mschlenstedt/WeatherLox/README.md

# WeatherLox
DIY Weatherstation for Smarthomes and amateur meteorologist and enthusiasts.

https://www.weatherlox.de/
