mschlenstedt/WeatherLox/PCB/weatherlox-air/README.md

# WeatherLox
DIY Weatherstation for Smarthomes and amateur meteorologist and enthusiasts.

This PCB is for the temperature, humidity and air pressur sensor.





The breadboard looks like this:

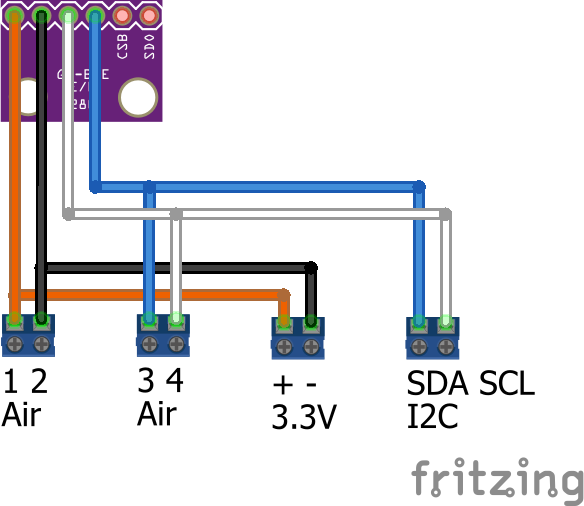
[picture p1: PCB/weatherlox-air/pictures/weatherlox-air-pcb_Steckplatine.png]
Breadboard for ESP32 Bottom
