mschlenstedt/WeatherLox/PCB/weatherlox-esp/README.md

# WeatherLox
DIY Weatherstation for Smarthomes and amateur meteorologist and enthusiasts.

This PCB is for the ESP32 and the additional Analog-Digital converter ADS1115 and the DC-DC step down.





The breadboard looks like this:

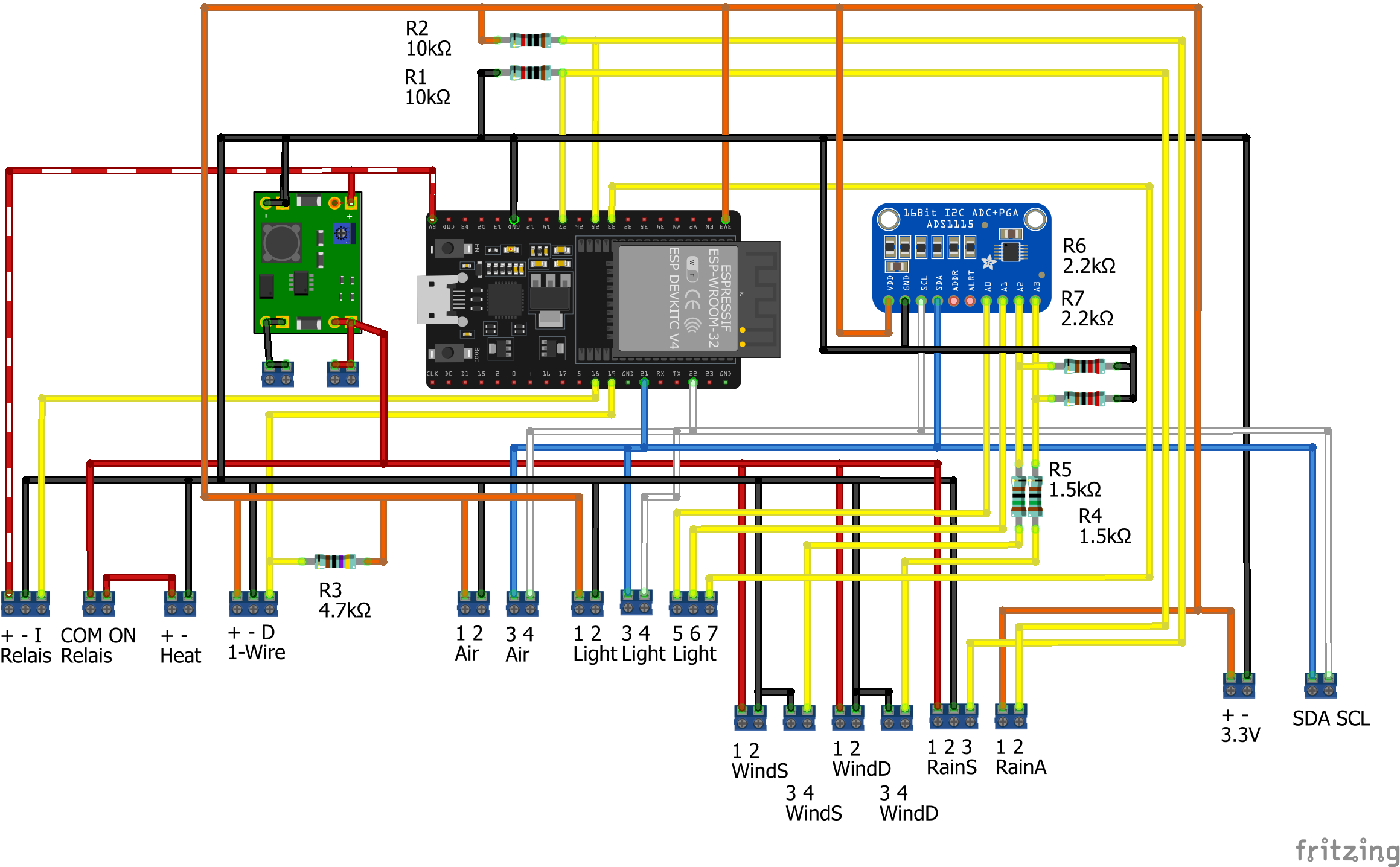
[picture p2: PCB/weatherlox-esp/pictures/weatherlox-esp-pcb_Steckplatine.png]
Breadboard for ESP32 Bottom
