mschlenstedt/WeatherLox/PCB/weatherlox-solar/README.md

# WeatherLox
DIY Weatherstation for Smarthomes and amateur meteorologist and enthusiasts.

This PCB is for the solar and light sensors as well as for the franklin sensor.





The breadboard looks like this:

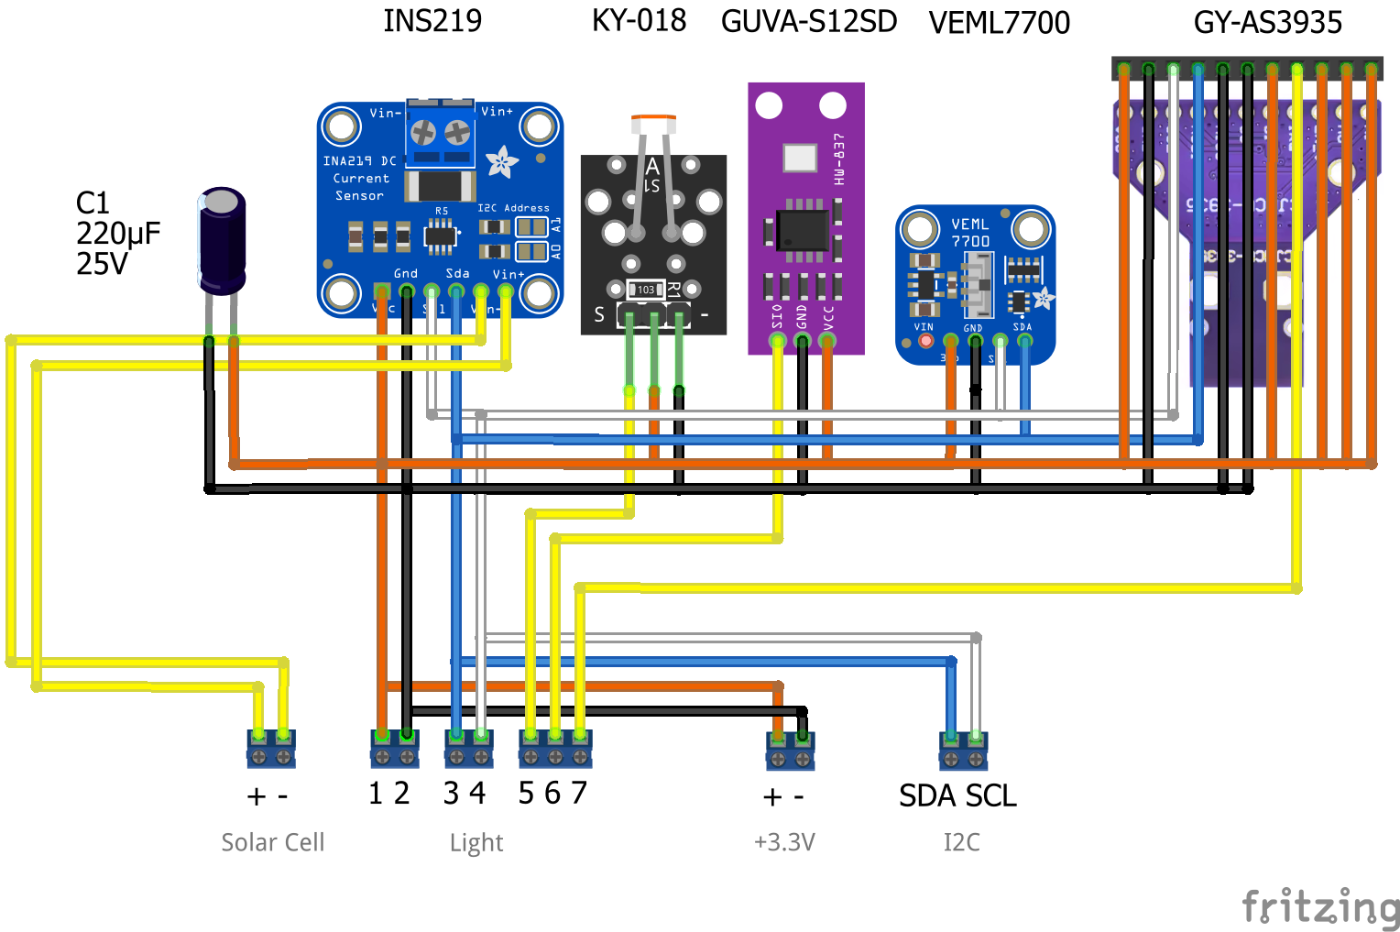
[picture p3: PCB/weatherlox-solar/pictures/weatherlox-solar-pcb_Steckplatine.png]
Breadboard for ESP32 Bottom
