mschlenstedt/WeatherLox/case/weatherlox-air/WeatherLox-Air-Adapter.step

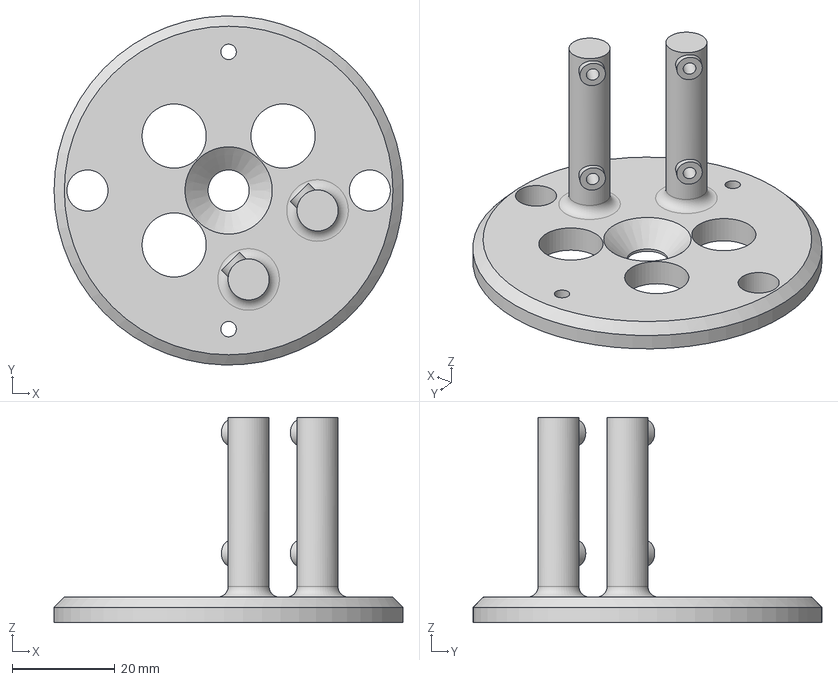
[picture p4: CAD file, 2026-03-01]
case/weatherlox-air/WeatherLox-Air-Adapter.step
67.9 x 68.0 x 40.0 mm
