mschlenstedt/WeatherLox/case/weatherlox-esp/Oberteil.stl

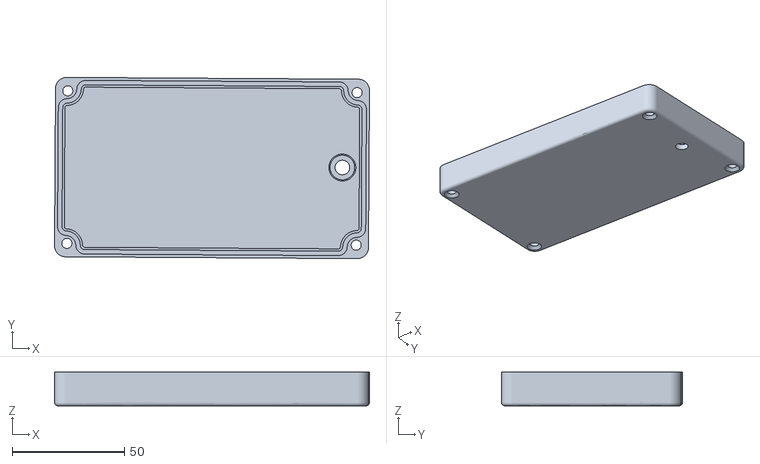
[picture p5: CAD file, 2026-01-30]
case/weatherlox-esp/Oberteil.stl
140.4 x 80.8 x 15.0
