mschlenstedt/WeatherLox/case/weatherlox-rain/WeatherLox-Rain-Adapter.step

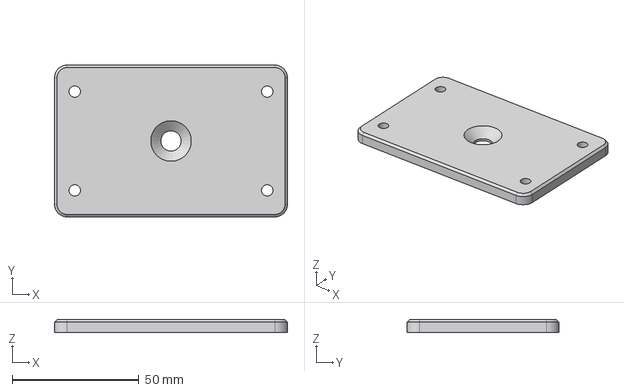
[picture p6: CAD file, 2026-03-01]
case/weatherlox-rain/WeatherLox-Rain-Adapter.step
92.0 x 60.0 x 5.00 mm
