mschlenstedt/WeatherLox/case/weatherlox-solar/Innenteil-2.stl

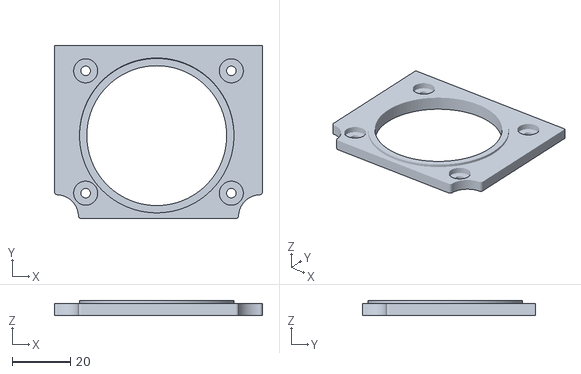
[picture p7: CAD file, 2026-01-30]
case/weatherlox-solar/Innenteil-2.stl
71.4 x 59.5 x 5.00
