mschlenstedt/WeatherLox/case/weatherlox-wind/WeatherLox-Wind-Adapter.step

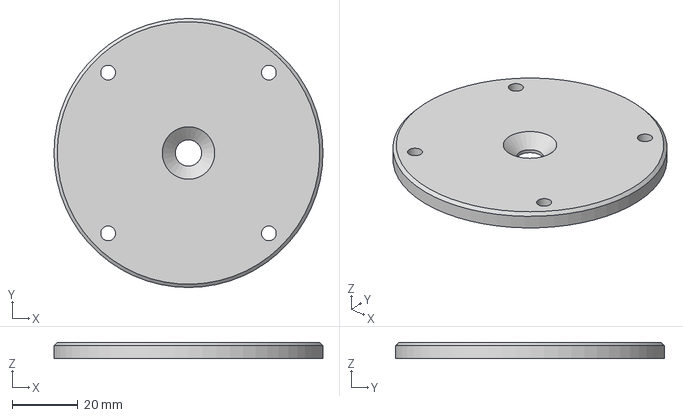
[picture p8: CAD file, 2026-01-02]
case/weatherlox-wind/WeatherLox-Wind-Adapter.step
82.0 x 82.0 x 5.00 mm
