mschlenstedt/WeatherLox/case/weatherlox-esp/Unterteil.stl

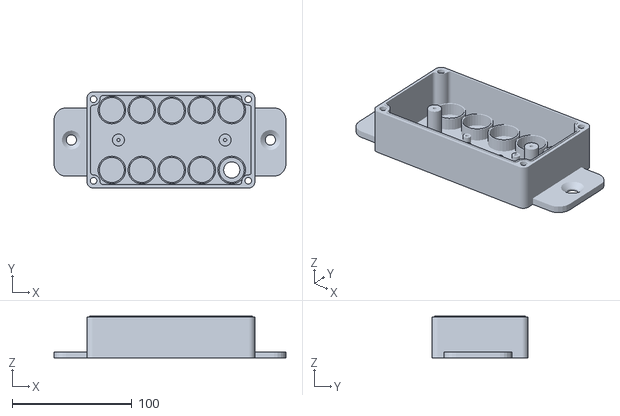
[picture p9: CAD file, 2026-01-30]
case/weatherlox-esp/Unterteil.stl
193.5 x 80.0 x 35.0
