mschlenstedt/WeatherLox/case/weatherlox-solar/Unterteil.stl

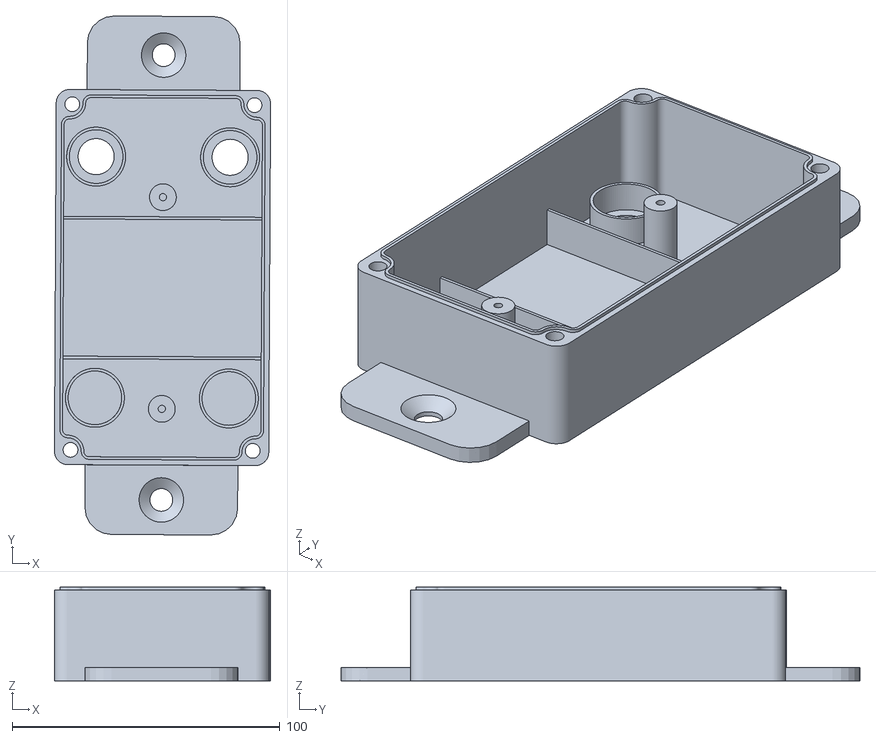
[picture p10: CAD file, 2026-01-30]
case/weatherlox-solar/Unterteil.stl
80.7 x 193.7 x 35.0
