mschlenstedt/WeatherLox/case/weatherlox-solar/Oberteil.stl

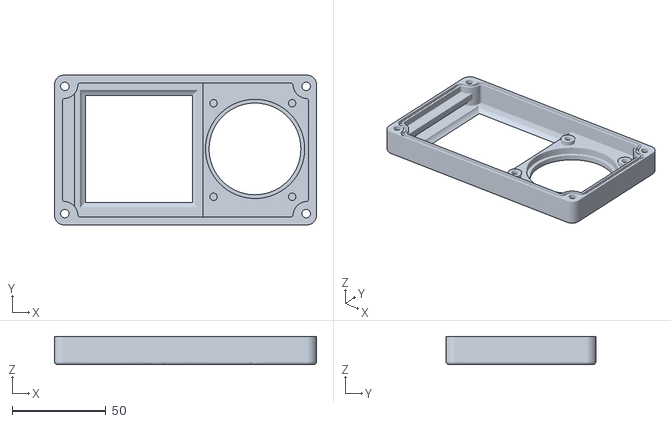
[picture p11: CAD file, 2026-01-30]
case/weatherlox-solar/Oberteil.stl
140.0 x 80.0 x 15.0
