mschlenstedt/WeatherLox/case/weatherlox-solar/Innenteil-1.stl

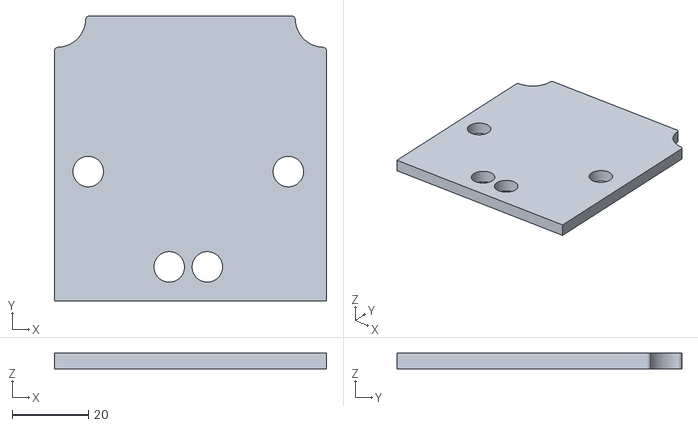
[picture p12: CAD file, 2026-01-30]
case/weatherlox-solar/Innenteil-1.stl
71.4 x 74.8 x 4.10
