mschlenstedt/WeatherLox/(list of files, cad)

Other CAD files:
case/weatherlox-air/WeatherLox-Air-Adapter.f3d
case/weatherlox-air/WeatherLox-Air-Adapter.stl
case/weatherlox-rain/WeatherLox-Rain-Adapter.f3d
case/weatherlox-rain/WeatherLox-Rain-Adapter.stl
case/weatherlox-wind/WeatherLox-Wind-Adapter.f3d
case/weatherlox-wind/WeatherLox-Wind-Adapter.stl
