mschlenstedt/WeatherLox/PCB/weatherlox-esp/weatherlox-esp-pcb_Schaltplan.pdf

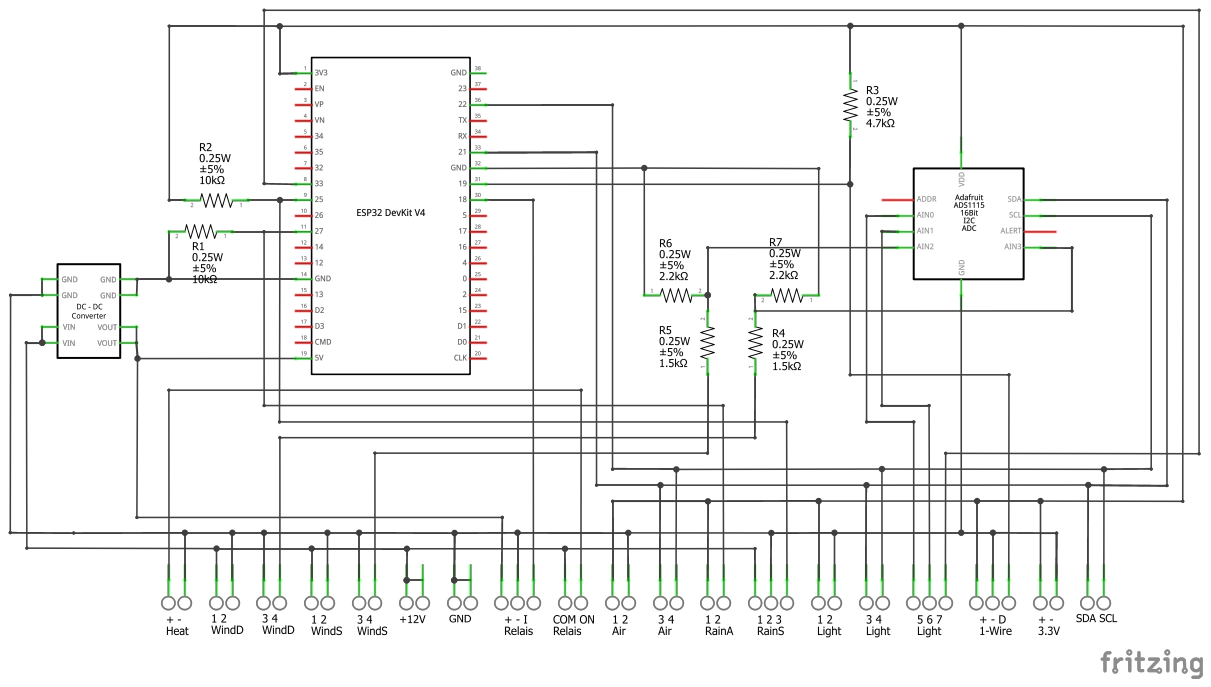
[picture p13: page 1]
