mschlenstedt/WeatherLox/PCB/weatherlox-air/weatherlox-air-pcb_Schaltplan.pdf

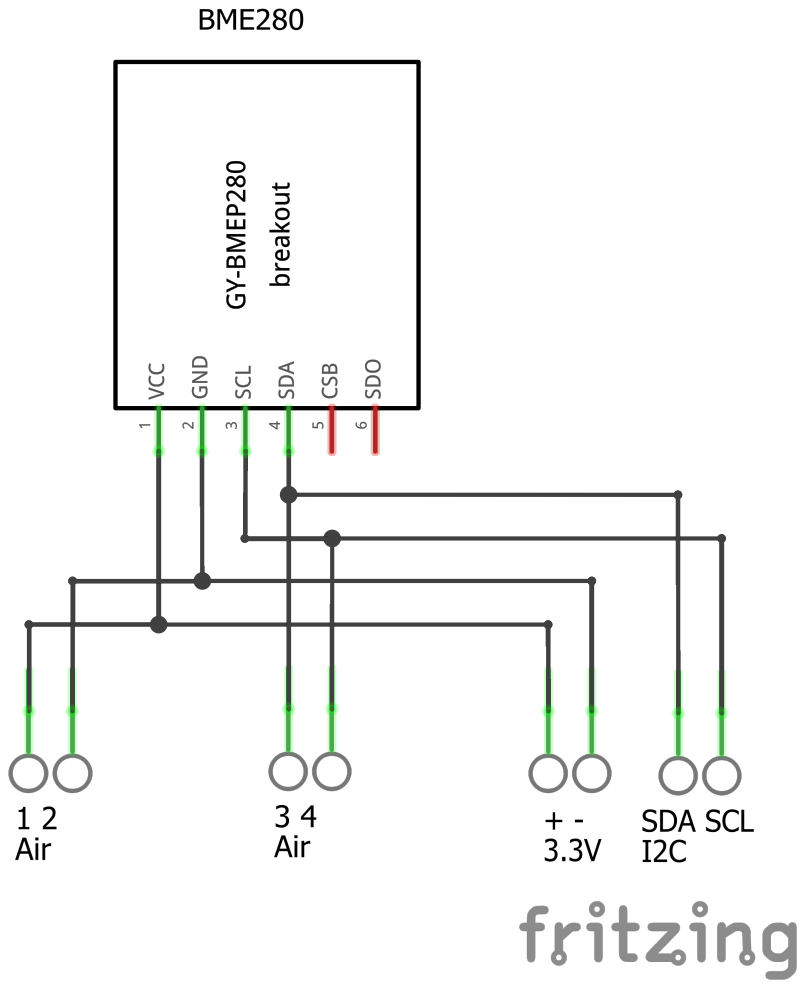
[picture p14: page 1]
