mschlenstedt/WeatherLox/PCB/weatherlox-solar/weatherlox-solar-pcb_Schaltplan.pdf

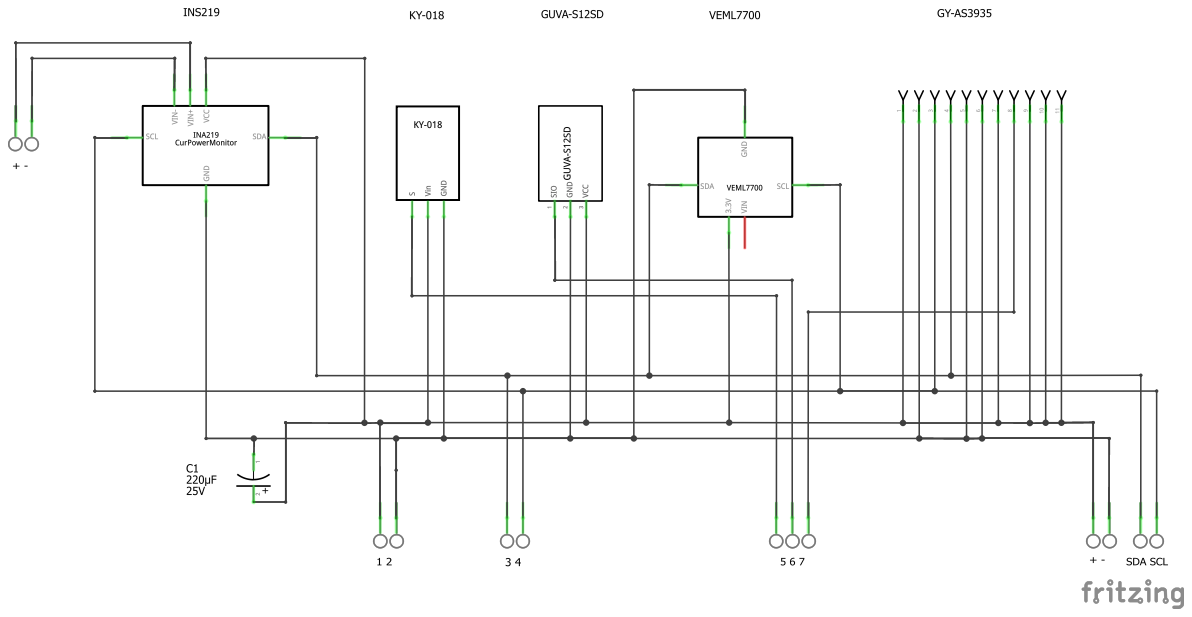
[picture p15: page 1]
