mschlenstedt/WeatherLox/(list of files, drawings)

Other design files:
PCB/weatherlox-air/weatherlox-air-pcb.fzz
PCB/weatherlox-esp/weatherlox-esp-pcb.fzz
PCB/weatherlox-solar/weatherlox-solar-pcb.fzz
