mschlenstedt/WeatherLox/(commit log)

2025-11-09 Update README.md to remove image size attributes
    Removed image size specifications from PCB images.
2025-11-09 Create README.md for WeatherLox PCB project
    Added README for WeatherLox project with details on the PCB.
2025-11-14 Gerber Files with correct Grounding
    [weatherlox-esp-pcb_contour.gm1, weatherlox-esp-pcb_copperBottom.gbl, weatherlox-esp-pcb_copperTop.gtl, weatherlox-esp-pcb_maskBottom.gbs, weatherlox-esp-pcb_maskTop.gts, weatherlox-esp-pcb_silkBottom.gbo, weatherlox-esp-pcb_silkTop.gto, weatherlox-solar-pcb_contour.gm1]
2025-11-28 Capacitor changed to 220uF / 25V
    [weatherlox-solar-pcb.fzz]
2025-12-15 Extension; Bugfixes
    [weatherlox-solar-pcb.fzz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]
2026-01-02 Update Case and Pictures
    [WeatherLox-Air-Adapter.f3d, WeatherLox-Air-Adapter.step, WeatherLox-Air-Adapter.stl, WeatherLox-Wind-Adapter.f3d, WeatherLox-Wind-Adapter.step, WeatherLox-Wind-Adapter.stl]
2026-01-30 ESP und Solar Gehäuse, Firmware
    [Innenteil-1.stl, Innenteil-2.stl, Oberteil.stl, Unterteil.stl]
2026-02-17 Version for SHT3x Sensors
    [WeatherLox-Air-Adapter.f3d, WeatherLox-Air-Adapter.step, WeatherLox-Air-Adapter.stl]
2026-03-01 New cases
    [WeatherLox-Air-Adapter.f3d, WeatherLox-Air-Adapter.step, WeatherLox-Rain-Adapter.f3d, WeatherLox-Rain-Adapter.step, WeatherLox-Rain-Adapter.stl]
2026-10-17 Custom.h: rebased on Custom-sample.h of ESPEasy mega-20260720
    All WeatherLox settings carried over unchanged. Changes from the new
    template: DEFAULT_AP_DONT_FORCE_SETUP replaced by DEFAULT_AP_FORCE_SETUP
    (same behaviour), new Network/Buses menus hidden as in the template,
    Thingspeak event explicitly 0, updated header comment.
    Needed for atan2/fmod in rules (ESPEasy since 2025-12-13).
2026-10-17 Rules: current state from the running station, commented and minified
    rulesN_commented.txt is the rule set as it runs on the station (with
    comments). rulesN.txt is the memory-optimised version without comments,
    indentation and blank lines; only the settings block in rules1 keeps its
    comments.
    Changes against the previous version:
    - SHT3x support (sht3x_1, BMx280 as fallback), shared calctemps event
    - daily/weekly/... sums kept in variables instead of re-reading task values
    - sum values restored only once after a cold boot (sumvaluesset)
    - windchill formula typo fixed
    - files regrouped: 1 settings, 2 boot/OpenMeteo/JSON, 3 sensors, 4 timers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
2026-10-17 Rules 3: calctemps fixed and aligned with FOSHKplugin
    - absolute humidity from vapour pressure (old polynomial had a "**" typo
    and returned roughly twice the real value)
    - vapour pressure and dewpoint with Magnus coefficients (Alduchov-Eskridge)
    instead of the ESPEasy dewpoint approximation
    - heat index: simple equation always first, complex equation from 80 F,
    missing bracket in the high humidity adjustment fixed
    - windchill from 10 C / 4.828 km/h, feelslike logic as in FOSHKplugin
    - temperature/humidity written to data_8 inside calctemps only
2026-10-18 rules3: wind direction average with atan2_d/fmod instead of quadrant logic
    Needs firmware based on ESPEasy mega-20260720. Brackets work around an
    ESPEasy calculation bug with 2-argument functions.
2026-10-18 rules: cleanup (EnableSensors event, task interval for daily sums, pressure trend over exactly 1h/3h, comments)
    - TaskEnable list only once in event EnableSensors (rules2)
    - daily sums use the task interval instead of fixed 5 s
    - pressure trends compare with sample61/sample181 (sample1 is the newest)
    - TaskValueSet instead of TaskValueSetAndRun for windgust_maxdaily
    - fix comments
2026-10-18 rules: lightning rule, dummy tasks regrouped by topic, lightning_time as ULONG
    - new rule for AS3935 (lightning, lightning_time, lightning_daily) with
    daily reset; distance is the nearer of both sensor values
    - dummy tasks data_1..data_14 regrouped (air, pressure, rain, wind, sun,
    lightning, Open-Meteo, 1-Wire); new task data_15 (UInt32) for
    lightning_time, a float task value is only exact to 128 s
2026-10-18 rules: restore sum values after power loss
    - json.keys: fields are top-level in the getdata.php response
    - new event restoresums: values only from the current day/week/month/year,
    based on the timestamp of the last save (set by the server)
    - lightning_daily is saved and restored too
2026-10-18 rules: pressure independent of the sensor, BMP58x support with priority
    - new event calcpressure, called by BMx280 or BMP58x (Generic I2C, task
    bmp58x_1); the BMP58x wins while it delivers values
    - BMx280 temperature/humidity only without SHT3x and with humidity > 0
    (a BMP280 reports 0)
    - pressure trend from data_3 statistics instead of the BMx280 task
2026-10-18 rules: repeat web service requests until answered, save sums only after restore
    - station height, Ecowitt passkey and saved sums are requested in the
    5 minute timer (first run right after WiFi#Connected) until an answer
    arrived; restore attempts stop after 15 minutes
    - sums are saved only after the restore, the first timer run at startup
    overwrote the saved values with zeros before
2026-10-18 rules: automatic update of rules 2-4 via provisioning
    - rules1: setting autoupdate, hourly timer checks between 3:00 and 3:59
    provisioning/v0100/check.php with the versions of rules 2-4
    - server answers HTTP 226 if there are newer rules: Provision,Rules,2-4
    and reboot (no json.keys needed)
    - rules2-4: version blocks (On versionN, Let,rvN,10100)
2026-10-18 V1.1.0: version bump, minified rules, config.dat with regrouped tasks and BMP58x task
    - rulesN.txt generated from rulesN_commented.txt (comments, indentation and blank lines removed)
    - config.dat from the reference station: dummy tasks regrouped by topic, data_15 (UInt32 x4),
    task 6 bmp58x_1 (Generic I2C, BMP58x), bmx280_1 stats off; GPS and unit number reset
2026-10-18 Custom.h: enable P180 I2C Generic for the BMP58x
2026-10-18 Patch for ESPEasy provisioning download with FEATURE_TLS
    FEATURE_TLS=1 is set by platformio_core_defs.ini for all ESP32 builds, so it cannot be
    switched off in Custom.h (the TLS defines are reverted). The patch makes downloadFile()
    and downloadFirmware() read from the stream of the HTTPClient. Apply in the ESPEasy
    source before building: git apply ESPEasy_download_stream_fix.patch
2026-10-18 V1.1.1: default controller configuration, winddirsensor 0, Ecowitt body without trailing &
    - config.dat: controller 1 MQTT (C005, %sysname%/data/%valname%, LWT %sysname%/status,
    queue 30 / 10 ms so that all 15 data tasks fit), controller 2 ESPEasy P2P and
    controller 3 Ecowitt (Generic HTTP Advanced), all disabled and without host
    - rules1: winddirsensor 0 (0-360 degree sensor) as default
    - rules4: last Ecowitt block without trailing '&' (FOSHKplugin drops such a body)
2026-10-18 V1.1.2: relative air pressure as QFF (DWD formula)
    pressure_rel is now reduced to sea level with formula 7.3 of DWD Leitfaden
    Nr. 6 "Flugmeteorologie" (temperature and vapour pressure included) instead
    of %c_sea_pres_alt%.
2026-10-19 rules1: stationheight is the height above sea level of the pressure sensor
    The comment said "over ground". 0 takes the ground height of the
    coordinates from Open-Meteo. Image rebuilt with the new rules1.
2026-10-19 Rules V1.1.3: copy the 1-Wire temperatures to data_14
    The task ow_1 (DS18B20 and compatible, up to 4 sensors) had no rule,
    so temperature1-4 in data_14 always stayed empty. rules2 and rules4
    only get the new version number for the automatic update.
    Image rebuilt.
2026-10-22 Rules V1.1.5: rain amount from the rain sensor, rainrate falls back to 0.5
    - rules4: while only the rain sensor detects rain (rainrate 0.5 mm/h), credit
    0.5/720 mm every 5 s to all rain counters, at most one bucket (rainest)
    - rules3: a bucket pulse adds only the rest of the bucket (0.2 mm - rainest);
    new event addrain updates all rain counters
    - rules4: no pulse for 600 s while the rain sensor is wet: rainrate back to 0.5
    - rules2-4 all at V1.1.5 again (V1.1.4 had bumped rules4 only, so
    update_rules.php rejected the differing versions)
2026-10-22 Rules V1.1.6: sum values after a restart and a power loss
    - Warm restart: the task values survive in the RTC memory, the variables do
    not. Rules 3 takes over the task value before each addition; the restore
    takes the bigger of saved and current value instead of overwriting.
    - Power loss (%bootcause%=1): the restore adds the saved values to the ones
    counted since the start. Only once per start.
    - Restore only with a valid time (no 1970 clock before NTP), requested right
    at Time#Initialized; no 15 min timeout, nothing is saved before the restore.
    - Until the sums are valid, the sum tasks are blocked (TaskInit) and Ecowitt
    sends nothing. With ESPEasy fix #5668 (settings.controllerN.en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
2026-10-23 Rules V1.1.7: rain and gust of the last 24 h, sunshine duration for Ecowitt
    - New tasks internal_3 (hourly statistics) and data_16 (windgust_maxhourly,
    windgust_max24h, rain_24h) in config.dat and the full image
    - rain_24h and windgust_max24h from the last 23 full hours plus the current
    hour, at least the daily value; data_16 is blocked after a power loss like
    the other sum tasks
    - Ecowitt: sunhours, last24hrainin, windgustmph_max24h
    - Stations without the new tasks (automatic Rules update) skip the 24 h values
    - internal_2: statistics enabled for int_random
2026-10-30 Rules V1.1.10: do not re-enable the BMP58x task
    BMP58x is not part of the official station. EnableSensors switched the
    task on every 5 minutes, and without the sensor it exited right away,
    so every run caused a TaskExit event that went through all rules.
